JoelObinnaEze/fpga-2d-graphics-accelerator/rtl/memory/sdram_framebuffer_core.sv

`timescale 1ns/1ps

// Portable controller/pixel-domain core for SDRAM-backed RGB565 scanout.
// The controller domain initializes one framebuffer with color bars, tracks
// committed writes, and continuously prefetches sequential pixel pairs. A
// 32-bit asynchronous FIFO carries packed words into the video domain, where
// each word is emitted as two RGB565 pixels. Scanout is enabled only at VBlank
// after initialization and FIFO prefill; underflow outputs black and latches a
// sticky diagnostic.
module sdram_framebuffer_core #(
    parameter int unsigned FRAME_WIDTH = 640,
    parameter int unsigned FRAME_HEIGHT = 480,
    parameter int unsigned READ_FIFO_DEPTH = 512,
    parameter int unsigned READ_FIFO_LOW_WATER = 256,
    parameter int unsigned READ_BURST_PIXELS = 32,
    parameter int unsigned WRITE_FIFO_DEPTH = 64,
    parameter int unsigned BUFFER0_BASE = 0,
    parameter int unsigned BUFFER1_BASE = FRAME_WIDTH * FRAME_HEIGHT
) (
    input  logic controller_clk,
    input  logic controller_rst,
    input  logic pixel_clk,
    input  logic pixel_rst,
    input  logic active_video,
    input  logic vblank_start,
    input  logic vblank_active,
    output logic [15:0] pixel,
    output logic framebuffer_ready,
    output logic initialization_active,
    output logic prefetch_active,
    output logic prefetch_complete,
    output logic scanout_enabled,
    output logic scanout_underflow,
    output logic write_protocol_error,
    input  logic renderer_write_valid,
    output logic renderer_write_ready,
    input  logic [21:0] renderer_write_pixel_address,
    input  logic [15:0] renderer_write_data,
    input  logic present_valid,
    output logic present_ready,
    input  logic [7:0] present_sequence,
    output logic present_pending,
    output logic present_done,
    output logic [7:0] completed_sequence,
    output logic [21:0] front_buffer_base,
    output logic [21:0] draw_buffer_base,
    output logic draw_allowed,
    output logic writes_committed,
    input  logic controller_init_done,
    input  logic controller_busy_n,
    input  logic controller_ack,
    input  logic controller_read_valid,
    input  logic [31:0] controller_read_data,
    output logic controller_write_n,
    output logic controller_read_n,
    output logic [20:0] controller_address,
    output logic [7:0] controller_data_len,
    output logic [3:0] controller_data_mask,
    output logic [31:0] controller_write_data
);
    localparam int unsigned FRAME_PIXELS = FRAME_WIDTH * FRAME_HEIGHT;
    localparam int unsigned READ_FIFO_WORD_DEPTH = READ_FIFO_DEPTH / 2;
    localparam int unsigned READ_LEVEL_WIDTH =
        $clog2(READ_FIFO_WORD_DEPTH + 1);
    localparam int unsigned WRITE_LEVEL_WIDTH =
        $clog2(WRITE_FIFO_DEPTH + 1);
    localparam int unsigned PREFILL_WORDS = READ_FIFO_LOW_WATER / 2;

    logic initializer_start_valid;
    logic initializer_start_ready;
    logic initializer_write_valid;
    logic initializer_write_ready;
    logic [21:0] initializer_write_address;
    logic [15:0] initializer_write_data;
    logic initializer_complete;
    logic initialization_started;
    typedef enum logic [1:0] {
        INIT_BUFFER0,
        INIT_BUFFER1,
        INIT_DRAIN,
        INIT_DONE
    } initialization_state_t;
    initialization_state_t initialization_state;

    logic selected_write_valid;
    logic selected_write_ready;
    logic [21:0] selected_write_address;
    logic [15:0] selected_write_data;
    logic renderer_address_valid;
    logic renderer_address_error;

    logic queued_write_valid;
    logic queued_write_ready;
    logic [21:0] queued_write_address;
    logic [15:0] queued_write_data;
    logic buffered_write_valid;
    logic buffered_write_ready;
    logic [21:0] buffered_write_address;
    logic [15:0] buffered_write_data;
    logic [WRITE_LEVEL_WIDTH-1:0] write_queue_count;
    logic [$clog2(2 + 1)-1:0] outstanding_write_count;
    logic adapter_write_committed;

    logic prefetch_start_valid;
    logic prefetch_start_ready;
    logic prefetch_request_valid;
    logic prefetch_request_ready;
    logic [21:0] prefetch_request_address;
    logic [7:0] prefetch_request_data_len;
    logic buffered_read_valid;
    logic buffered_read_ready;
    logic [21:0] buffered_read_address;
    logic [7:0] buffered_read_data_len;

    logic [READ_LEVEL_WIDTH-1:0] read_fifo_write_level;
    logic [READ_LEVEL_WIDTH-1:0] scheduled_fifo_level;
    logic read_fifo_write_valid;
    logic read_fifo_write_ready;
    logic [31:0] read_fifo_write_data;
    logic read_fifo_read_valid;
    logic read_fifo_read_ready;
    logic [31:0] read_fifo_read_data;
    logic [READ_LEVEL_WIDTH-1:0] read_fifo_read_level;

    logic arbiter_memory_valid;
    logic arbiter_memory_ready;
    logic [1:0] arbiter_memory_operation;
    logic [31:0] arbiter_memory_address;
    logic [15:0] arbiter_memory_write_data;
    logic [7:0] arbiter_memory_data_len;
    logic refresh_ready;
    logic address_upper_zero;
    logic adapter_response_valid;
    logic adapter_response_ready;
    logic [31:0] adapter_response_data;
    logic adapter_read_protocol_error;
    logic write_queue_protocol_error;

    logic presenter_ready;
    logic presenter_draw_allowed;
    logic [31:0] presenter_front_buffer_base;
    logic [31:0] presenter_draw_buffer_base;
    logic presenter_base_error;
    logic prefetch_restart;
    logic new_front_prefill_ready;

    typedef enum logic [2:0] {
        PREFETCH_NORMAL,
        FLUSH_WAIT_HIGH,
        FLUSH_WAIT_LOW,
        PREFILL_START,
        PREFILL_WAIT
    } prefetch_control_state_t;
    prefetch_control_state_t prefetch_control_state;
    logic prefetch_start_fire;
    logic read_fifo_flush_request;
    logic front_stream_ready;

    logic vblank_toggle;
    (* async_reg = "true" *) logic vblank_toggle_sync1;
    (* async_reg = "true" *) logic vblank_toggle_sync2;
    logic vblank_toggle_previous;
    logic controller_vblank_start;

    (* async_reg = "true" *) logic flush_request_sync1;
    (* async_reg = "true" *) logic flush_request_sync2;
    logic read_fifo_flush_ack;
    (* async_reg = "true" *) logic flush_ack_sync1;
    (* async_reg = "true" *) logic flush_ack_sync2;
    (* async_reg = "true" *) logic front_stream_ready_sync1;
    (* async_reg = "true" *) logic front_stream_ready_sync2;

    logic pixel_upper_half;

    initial begin
        if (FRAME_PIXELS == 0 || BUFFER0_BASE + FRAME_PIXELS > 4194304 ||
            BUFFER1_BASE + FRAME_PIXELS > 4194304)
            $error("frame size must fit the 22-bit pixel-address space");
        if (BUFFER0_BASE % 2 != 0 || BUFFER1_BASE % 2 != 0)
            $error("packed framebuffer bases must be even pixel addresses");
        if (FRAME_PIXELS % 2 != 0 || READ_FIFO_DEPTH % 2 != 0 ||
            READ_FIFO_LOW_WATER % 2 != 0 || READ_BURST_PIXELS % 2 != 0)
            $error("packed scanout parameters must be even");
    end

    assign initializer_start_valid = controller_init_done &&
        !initialization_started &&
        (initialization_state == INIT_BUFFER0 ||
         initialization_state == INIT_BUFFER1);
    assign prefetch_start_valid = framebuffer_ready &&
        ((prefetch_control_state == PREFETCH_NORMAL && !present_pending) ||
         prefetch_control_state == PREFILL_START);
    assign prefetch_start_fire = prefetch_start_valid &&
                                 prefetch_start_ready;

    always_comb begin
        renderer_address_valid = int'(renderer_write_pixel_address) <
                                 FRAME_PIXELS;
        selected_write_valid = 1'b0;
        selected_write_address = '0;
        selected_write_data = '0;
        initializer_write_ready = 1'b0;
        renderer_write_ready = 1'b0;

        if (initialization_state != INIT_DONE) begin
            selected_write_valid = initializer_write_valid;
            selected_write_address = initializer_write_address;
            selected_write_data = initializer_write_data;
            initializer_write_ready = selected_write_ready;
        end else if (draw_allowed) begin
            selected_write_valid = renderer_write_valid &&
                                   renderer_address_valid;
            selected_write_address = draw_buffer_base +
                                     renderer_write_pixel_address;
            selected_write_data = renderer_write_data;
            renderer_write_ready = renderer_address_valid
                                 ? selected_write_ready : 1'b1;
        end
    end

    framebuffer_colorbar_writer #(
        .FRAME_WIDTH(FRAME_WIDTH),
        .FRAME_HEIGHT(FRAME_HEIGHT)
    ) initializer (
        .clk(controller_clk),
        .rst(controller_rst),
        .start_valid(initializer_start_valid),
        .start_ready(initializer_start_ready),
        .start_pixel_address(initialization_state == INIT_BUFFER1
                           ? 22'(BUFFER1_BASE) : 22'(BUFFER0_BASE)),
        .write_valid(initializer_write_valid),
        .write_ready(initializer_write_ready),
        .write_pixel_address(initializer_write_address),
        .write_data(initializer_write_data),
        .active(initialization_active),
        .complete(initializer_complete)
    );

    framebuffer_write_queue #(
        .FIFO_DEPTH(WRITE_FIFO_DEPTH),
        .MAX_OUTSTANDING_WRITES(2)
    ) write_queue (
        .clk(controller_clk),
        .rst(controller_rst),
        .write_valid(selected_write_valid),
        .write_ready(selected_write_ready),
        .write_pixel_address(selected_write_address),
        .write_data(selected_write_data),
        .arbiter_valid(queued_write_valid),
        .arbiter_ready(queued_write_ready),
        .arbiter_pixel_address(queued_write_address),
        .arbiter_write_data(queued_write_data),
        .backend_write_committed(adapter_write_committed),
        .writes_committed,
        .queue_count(write_queue_count),
        .outstanding_count(outstanding_write_count),
        .protocol_error(write_queue_protocol_error)
    );

    framebuffer_read_prefetch #(
        .FRAME_PIXELS(FRAME_PIXELS),
        .FIFO_DEPTH(READ_FIFO_DEPTH),
        .FIFO_LOW_WATER(READ_FIFO_LOW_WATER),
        .BURST_PIXELS(READ_BURST_PIXELS)
    ) prefetch (
        .clk(controller_clk),
        .rst(controller_rst),
        .start_valid(prefetch_start_valid),
        .start_ready(prefetch_start_ready),
        .start_pixel_address(front_buffer_base),
        .active(prefetch_active),
        .complete(prefetch_complete),
        .fifo_write_level(scheduled_fifo_level),
        .fifo_write_valid(read_fifo_write_valid),
        .fifo_write_ready(read_fifo_write_ready),
        .fifo_write_data(read_fifo_write_data),
        .request_valid(prefetch_request_valid),
        .request_ready(prefetch_request_ready),
        .request_pixel_address(prefetch_request_address),
        .request_data_len(prefetch_request_data_len),
        .response_valid(adapter_response_valid),
        .response_ready(adapter_response_ready),
        .response_read_data(adapter_response_data)
    );

    frame_presenter #(
        .BUFFER0_BASE(BUFFER0_BASE),
        .BUFFER1_BASE(BUFFER1_BASE)
    ) presenter (
        .clk(controller_clk),
        .rst(controller_rst),
        .present_valid(present_valid && framebuffer_ready),
        .present_ready(presenter_ready),
        .present_sequence,
        .writes_committed(writes_committed && !prefetch_active),
        .vblank_start(controller_vblank_start),
        .prefetch_ready(new_front_prefill_ready),
        .front_buffer_base(presenter_front_buffer_base),
        .draw_buffer_base(presenter_draw_buffer_base),
        .draw_allowed(presenter_draw_allowed),
        .present_pending,
        .prefetch_restart,
        .present_done,
        .completed_sequence
    );

    framebuffer_arbiter #(
        .READ_FIFO_LOW_WATER(READ_FIFO_LOW_WATER / 2),
        .MAX_CONSECUTIVE_WRITES(32)
    ) arbiter (
        .clk(controller_clk),
        .rst(controller_rst),
        .read_fifo_level(16'(scheduled_fifo_level)),
        .scanout_valid(buffered_read_valid),
        .scanout_ready(buffered_read_ready),
        .scanout_address({10'd0, buffered_read_address}),
        .scanout_data_len(buffered_read_data_len),
        .write_valid(buffered_write_valid),
        .write_ready(buffered_write_ready),
        .write_address({10'd0, buffered_write_address}),
        .write_data(buffered_write_data),
        .refresh_valid(1'b0),
        .refresh_ready,
        .memory_valid(arbiter_memory_valid),
        .memory_ready(arbiter_memory_ready),
        .memory_operation(arbiter_memory_operation),
        .memory_address(arbiter_memory_address),
        .memory_write_data(arbiter_memory_write_data),
        .memory_data_len(arbiter_memory_data_len)
    );

    sdram_pixel_adapter adapter (
        .clk(controller_clk),
        .rst(controller_rst),
        .request_valid(arbiter_memory_valid && address_upper_zero),
        .request_ready(arbiter_memory_ready),
        .request_operation(arbiter_memory_operation),
        .request_pixel_address(arbiter_memory_address[21:0]),
        .request_write_data(arbiter_memory_write_data),
        .request_data_len(arbiter_memory_data_len),
        .response_valid(adapter_response_valid),
        .response_ready(adapter_response_ready),
        .response_read_data(adapter_response_data),
        .write_committed(adapter_write_committed),
        .read_protocol_error(adapter_read_protocol_error),
        .controller_init_done,
        .controller_busy_n,
        .controller_ack,
        .controller_read_valid,
        .controller_read_data,
        .controller_write_n,
        .controller_read_n,
        .controller_address,
        .controller_data_len,
        .controller_data_mask,
        .controller_write_data
    );

    async_fifo #(
        .WIDTH(32),
        .DEPTH(READ_FIFO_WORD_DEPTH),
        // This module is the only writer, and its scheduler reserves no more
        // than 144 of the 256 packed-word slots in hardware.
        .EXTERNAL_CAPACITY_CONTROL(1'b1)
    ) read_fifo (
        .write_clk(controller_clk),
        .write_rst(controller_rst),
        .write_valid(read_fifo_write_valid),
        .write_ready(read_fifo_write_ready),
        .write_data(read_fifo_write_data),
        .write_level(read_fifo_write_level),
        .read_clk(pixel_clk),
        .read_rst(pixel_rst),
        .read_valid(read_fifo_read_valid),
        .read_ready(read_fifo_read_ready),
        .read_data(read_fifo_read_data),
        .read_level(read_fifo_read_level)
    );

    always_ff @(posedge controller_clk) begin
        if (controller_rst) begin
            scheduled_fifo_level <= '0;
            buffered_read_valid <= 1'b0;
            buffered_read_address <= '0;
            buffered_read_data_len <= '0;
            buffered_write_valid <= 1'b0;
            buffered_write_address <= '0;
            buffered_write_data <= '0;
            initialization_started <= 1'b0;
            initialization_state <= INIT_BUFFER0;
            framebuffer_ready <= 1'b0;
            renderer_address_error <= 1'b0;
            prefetch_control_state <= PREFETCH_NORMAL;
            read_fifo_flush_request <= 1'b0;
            front_stream_ready <= 1'b0;
            vblank_toggle_sync1 <= 1'b0;
            vblank_toggle_sync2 <= 1'b0;
            vblank_toggle_previous <= 1'b0;
            flush_ack_sync1 <= 1'b0;
            flush_ack_sync2 <= 1'b0;
        end else begin
            vblank_toggle_sync1 <= vblank_toggle;
            vblank_toggle_sync2 <= vblank_toggle_sync1;
            vblank_toggle_previous <= vblank_toggle_sync2;
            flush_ack_sync1 <= read_fifo_flush_ack;
            flush_ack_sync2 <= flush_ack_sync1;

            // Break the Gray-pointer decode/subtract path before arbitration.
            // framebuffer_read_prefetch waits one settle cycle after every
            // response, so this conservative pipeline cannot over-reserve.
            scheduled_fifo_level <= read_fifo_write_level;
            if (buffered_read_valid) begin
                if (buffered_read_ready)
                    buffered_read_valid <= 1'b0;
            end else if (prefetch_request_valid) begin
                    buffered_read_valid <= 1'b1;
                    buffered_read_address <= prefetch_request_address;
                    buffered_read_data_len <= prefetch_request_data_len;
            end
            if (buffered_write_valid) begin
                if (buffered_write_ready)
                    buffered_write_valid <= 1'b0;
            end else if (queued_write_valid) begin
                buffered_write_valid <= 1'b1;
                buffered_write_address <= queued_write_address;
                buffered_write_data <= queued_write_data;
            end
            if (initializer_start_valid && initializer_start_ready)
                initialization_started <= 1'b1;
            if (initializer_complete) begin
                initialization_started <= 1'b0;
                if (initialization_state == INIT_BUFFER0)
                    initialization_state <= INIT_BUFFER1;
                else if (initialization_state == INIT_BUFFER1)
                    initialization_state <= INIT_DRAIN;
            end
            if (initialization_state == INIT_DRAIN &&
                !initialization_active && write_queue_count == 0 &&
                outstanding_write_count == 0 && writes_committed &&
                !refresh_ready) begin
                initialization_state <= INIT_DONE;
                framebuffer_ready <= 1'b1;
            end

            if (renderer_write_valid && renderer_write_ready &&
                !renderer_address_valid)
                renderer_address_error <= 1'b1;

            case (prefetch_control_state)
                PREFETCH_NORMAL: begin
                    if (prefetch_restart) begin
                        read_fifo_flush_request <= 1'b1;
                        front_stream_ready <= 1'b0;
                        prefetch_control_state <= FLUSH_WAIT_HIGH;
                    end else if (!front_stream_ready && framebuffer_ready &&
                                 int'(scheduled_fifo_level) >=
                                 PREFILL_WORDS) begin
                        front_stream_ready <= 1'b1;
                    end
                end

                FLUSH_WAIT_HIGH: begin
                    if (flush_ack_sync2) begin
                        read_fifo_flush_request <= 1'b0;
                        prefetch_control_state <= FLUSH_WAIT_LOW;
                    end
                end

                FLUSH_WAIT_LOW: begin
                    if (!flush_ack_sync2)
                        prefetch_control_state <= PREFILL_START;
                end

                PREFILL_START: begin
                    if (prefetch_start_fire)
                        prefetch_control_state <= PREFILL_WAIT;
                end

                PREFILL_WAIT: begin
                    if (int'(scheduled_fifo_level) >= PREFILL_WORDS) begin
                        front_stream_ready <= 1'b1;
                        prefetch_control_state <= PREFETCH_NORMAL;
                    end
                end

                default: prefetch_control_state <= PREFETCH_NORMAL;
            endcase
        end
    end

    // The adapter spends multiple cycles on every request, so a deliberately
    // non-fall-through slot costs no useful throughput and completely breaks
    // the arbitration ready path. The prefetcher counts a request as
    // outstanding when this slot accepts it.
    assign prefetch_request_ready = !buffered_read_valid;
    assign queued_write_ready = !buffered_write_valid;
    assign controller_vblank_start = vblank_toggle_sync2 ^
                                     vblank_toggle_previous;
    assign new_front_prefill_ready =
        prefetch_control_state == PREFILL_WAIT &&
        int'(scheduled_fifo_level) >= PREFILL_WORDS;

    always_ff @(posedge pixel_clk) begin
        if (pixel_rst) begin
            flush_request_sync1 <= 1'b0;
            flush_request_sync2 <= 1'b0;
            front_stream_ready_sync1 <= 1'b0;
            front_stream_ready_sync2 <= 1'b0;
            read_fifo_flush_ack <= 1'b0;
            vblank_toggle <= 1'b0;
            scanout_enabled <= 1'b0;
            scanout_underflow <= 1'b0;
            pixel_upper_half <= 1'b0;
        end else begin
            flush_request_sync1 <= read_fifo_flush_request;
            flush_request_sync2 <= flush_request_sync1;
            front_stream_ready_sync1 <= front_stream_ready;
            front_stream_ready_sync2 <= front_stream_ready_sync1;

            if (vblank_start)
                vblank_toggle <= ~vblank_toggle;

            if (flush_request_sync2) begin
                scanout_enabled <= 1'b0;
                pixel_upper_half <= 1'b0;
                read_fifo_flush_ack <= !read_fifo_read_valid;
            end else begin
                read_fifo_flush_ack <= 1'b0;

                if (!scanout_enabled && vblank_active &&
                    front_stream_ready_sync2 && read_fifo_read_level != 0 &&
                    read_fifo_read_valid)
                    scanout_enabled <= 1'b1;

                if (scanout_enabled && active_video) begin
                    if (read_fifo_read_valid)
                        pixel_upper_half <= ~pixel_upper_half;
                    else begin
                        pixel_upper_half <= 1'b0;
                        scanout_underflow <= 1'b1;
                    end
                end
            end
        end
    end

    always_comb begin
        address_upper_zero = arbiter_memory_address[31:22] == 0;
        read_fifo_read_ready = flush_request_sync2
                             ? read_fifo_read_valid
                             : scanout_enabled && active_video &&
                               read_fifo_read_valid && pixel_upper_half;
        pixel = scanout_enabled && active_video && read_fifo_read_valid
              ? (pixel_upper_half ? read_fifo_read_data[31:16]
                                  : read_fifo_read_data[15:0])
              : 16'h0000;
        present_ready = framebuffer_ready && presenter_ready;
        front_buffer_base = presenter_front_buffer_base[21:0];
        draw_buffer_base = presenter_draw_buffer_base[21:0];
        draw_allowed = framebuffer_ready && presenter_draw_allowed;
        presenter_base_error = |presenter_front_buffer_base[31:22] ||
                               |presenter_draw_buffer_base[31:22];
        write_protocol_error = write_queue_protocol_error ||
                               adapter_read_protocol_error ||
                               renderer_address_error || presenter_base_error;
    end
endmodule
