JoelObinnaEze/fpga-2d-graphics-accelerator/rtl/interface/command_decoder.sv

`timescale 1ns/1ps

module command_decoder (
    input  logic clk,
    input  logic rst,
    input  logic frame_start,
    input  logic frame_end,
    input  logic byte_valid,
    output logic byte_ready,
    input  logic [7:0] byte_data,
    output logic command_valid,
    input  logic command_ready,
    output command_pkg::command_t command,
    output logic protocol_error,
    output logic [15:0] protocol_error_count
);
    import command_pkg::*;

    typedef enum logic [3:0] {
        IDLE,
        EXPECT_MAGIC,
        EXPECT_OPCODE,
        EXPECT_LENGTH,
        EXPECT_SEQUENCE,
        EXPECT_PAYLOAD,
        EXPECT_CRC,
        WAIT_FRAME_END,
        DISCARD_FRAME
    } state_t;

    state_t state;
    logic [7:0] opcode;
    logic [7:0] payload_length;
    logic [3:0] payload_index;
    logic [7:0] running_crc;
    command_t assembled_command;

    function automatic logic [7:0] expected_length(input logic [7:0] value);
        case (value)
            OP_CLEAR:       return 8'd2;
            OP_DRAW_RECT:   return 8'd10;
            OP_DRAW_SPRITE: return 8'd6;
            OP_PRESENT:     return 8'd0;
            default:        return 8'hff;
        endcase
    endfunction

    function automatic logic [7:0] crc8_next(
        input logic [7:0] crc_in,
        input logic [7:0] data
    );
        logic [7:0] crc;
        crc = crc_in;
        for (int bit_index = 0; bit_index < 8; bit_index++) begin
            crc = (crc[7] ^ data[7-bit_index])
                ? {crc[6:0], 1'b0} ^ 8'h07
                : {crc[6:0], 1'b0};
        end
        return crc;
    endfunction

    always_comb begin
        byte_ready = !command_valid && state inside {
            EXPECT_MAGIC, EXPECT_OPCODE, EXPECT_LENGTH, EXPECT_SEQUENCE,
            EXPECT_PAYLOAD, EXPECT_CRC, DISCARD_FRAME
        };

    end

    always_ff @(posedge clk) begin
        if (rst) begin
            state <= IDLE;
            opcode <= '0;
            payload_length <= '0;
            payload_index <= '0;
            running_crc <= '0;
            assembled_command <= '0;
            command <= '0;
            command_valid <= 1'b0;
            protocol_error <= 1'b0;
            protocol_error_count <= '0;
        end else begin
            protocol_error <= 1'b0;
            if (command_valid && command_ready)
                command_valid <= 1'b0;

            if (frame_start) begin
                if (state != IDLE || command_valid) begin
                    state <= DISCARD_FRAME;
                    protocol_error <= 1'b1;
                    if (protocol_error_count != 16'hffff)
                        protocol_error_count <= protocol_error_count + 1'b1;
                end else begin
                    state <= EXPECT_MAGIC;
                    running_crc <= '0;
                    payload_index <= '0;
                    assembled_command <= '0;
                end
            end else if (frame_end) begin
                if (state == WAIT_FRAME_END || state == DISCARD_FRAME || state == IDLE) begin
                    state <= IDLE;
                end else begin
                    state <= IDLE;
                    protocol_error <= 1'b1;
                    if (protocol_error_count != 16'hffff)
                        protocol_error_count <= protocol_error_count + 1'b1;
                end
            end else if (byte_valid && byte_ready) begin
                case (state)
                    EXPECT_MAGIC: begin
                        if (byte_data == 8'ha5) begin
                            state <= EXPECT_OPCODE;
                        end else begin
                            state <= DISCARD_FRAME;
                            protocol_error <= 1'b1;
                            if (protocol_error_count != 16'hffff)
                                protocol_error_count <= protocol_error_count + 1'b1;
                        end
                    end
                    EXPECT_OPCODE: begin
                        opcode <= byte_data;
                        assembled_command.opcode <= opcode_t'(byte_data);
                        running_crc <= crc8_next(8'h00, byte_data);
                        state <= EXPECT_LENGTH;
                    end
                    EXPECT_LENGTH: begin
                        if (expected_length(opcode) == byte_data && byte_data != 8'hff) begin
                            payload_length <= byte_data;
                            running_crc <= crc8_next(running_crc, byte_data);
                            state <= EXPECT_SEQUENCE;
                        end else begin
                            state <= DISCARD_FRAME;
                            protocol_error <= 1'b1;
                            if (protocol_error_count != 16'hffff)
                                protocol_error_count <= protocol_error_count + 1'b1;
                        end
                    end
                    EXPECT_SEQUENCE: begin
                        assembled_command.sequence_id <= byte_data;
                        running_crc <= crc8_next(running_crc, byte_data);
                        state <= payload_length == 0 ? EXPECT_CRC : EXPECT_PAYLOAD;
                    end
                    EXPECT_PAYLOAD: begin
                        case (payload_index)
                            4'd0: assembled_command.arg0[7:0] <= byte_data;
                            4'd1: assembled_command.arg0[15:8] <= byte_data;
                            4'd2: assembled_command.arg1[7:0] <= byte_data;
                            4'd3: assembled_command.arg1[15:8] <= byte_data;
                            4'd4: assembled_command.arg2[7:0] <= byte_data;
                            4'd5: assembled_command.arg2[15:8] <= byte_data;
                            4'd6: assembled_command.arg3[7:0] <= byte_data;
                            4'd7: assembled_command.arg3[15:8] <= byte_data;
                            4'd8: assembled_command.arg4[7:0] <= byte_data;
                            4'd9: assembled_command.arg4[15:8] <= byte_data;
                            default: assembled_command <= assembled_command;
                        endcase
                        running_crc <= crc8_next(running_crc, byte_data);
                        if (8'(payload_index) + 8'd1 == payload_length) begin
                            state <= EXPECT_CRC;
                        end else begin
                            payload_index <= payload_index + 1'b1;
                        end
                    end
                    EXPECT_CRC: begin
                        if (byte_data == running_crc) begin
                            command <= assembled_command;
                            command_valid <= 1'b1;
                            state <= WAIT_FRAME_END;
                        end else begin
                            state <= DISCARD_FRAME;
                            protocol_error <= 1'b1;
                            if (protocol_error_count != 16'hffff)
                                protocol_error_count <= protocol_error_count + 1'b1;
                        end
                    end
                    default: state <= state;
                endcase
            end
        end
    end
endmodule
