JoelObinnaEze/fpga-2d-graphics-accelerator/(commit log)

2026-10-06 feat: present completed frames at vblank
2026-10-06 feat: emit Pong frames from RP2040 firmware
2026-10-07 feat: add Tang Nano 20K LED bring-up
2026-10-07 feat: add dual-clock framebuffer FIFO
2026-10-07 feat: add bounded framebuffer read prefetch
2026-10-07 feat: add committed framebuffer write queue
2026-10-07 feat: integrate SPI graphics command link
